jaafreitas/weather-station/station/sensorBMP280.cpp

#include "src/Adafruit_BMP280_Library/Adafruit_BMP280.h"
#include "sensorBMP280.h"
#include "settings.h"

extern "C" {
#include "user_interface.h"
}

Adafruit_BMP280 bmp;

os_timer_t sensorBMP280Timer;
bool canReadSensorBMP280 = false;

void sensorBMP280Read(void *parg) {
  canReadSensorBMP280 = true;
}

void setupSensorBMP280() {
  if (!bmp.begin()) {  
    Serial.println("BMP280 sensor not connected!");
  } else {
    canReadSensorBMP280 = true;
    os_timer_disarm(&sensorBMP280Timer);
    os_timer_setfn(&sensorBMP280Timer, sensorBMP280Read, NULL);
    os_timer_arm(&sensorBMP280Timer, SENSOR_BMP280_READ_INTERVAL, true);
  }
}

void loopSensorBMP280(Conn* conn) {
  if (canReadSensorBMP280) {
    canReadSensorBMP280 = false;

    float hPa = bmp.readPressure() / 100;

    conn->notify_sensor("BMP280/pressure", hPa);
    conn->notify_sensor("BMP280/temperature", bmp.readTemperature());
  }
}
