jaafreitas/weather-station/station/sensorMPXH6300A.cpp

#include "sensorMPXH6300A.h"
#include "settings.h"

extern "C" {
#include "user_interface.h"
}

os_timer_t sensorMPXH6300ATimer;

bool canReadSensorMPXH6300A = true;

void sensorMPXH6300ARead(void *parg) {
  canReadSensorMPXH6300A = true;
}

void setupSensorMPXH6300A() {
  pinMode(SENSOR_MPXH6300A_PIN, INPUT);

  os_timer_disarm(&sensorMPXH6300ATimer);
  os_timer_setfn(&sensorMPXH6300ATimer, sensorMPXH6300ARead, NULL);
  os_timer_arm(&sensorMPXH6300ATimer, SENSOR_MPXH6300A_READ_INTERVAL, true);
}

void loopSensorMPXH6300A(Conn* conn) {
  if (canReadSensorMPXH6300A) {
    canReadSensorMPXH6300A = false;

    int samples = 0;
    float sensorValue;
    while (samples < 1000) {
      sensorValue += analogRead(SENSOR_MPXH6300A_PIN);
      samples++;
    }
    sensorValue /= 1000;

    float volts = (sensorValue / 992.0) * VREF;
    float hPa = 10 * (volts + 0.00353 * VREF_5V) / (0.00318 * VREF_5V);

    if (hPa > 500.0) {
      conn->notify_sensor("MPXH6300A/pressure", hPa);
    }
  }
}
