jaafreitas/weather-station/station/debug.cpp

#include "src/Time/TimeLib.h"
#include "debug.h"
#include "settings.h"
#include "ntp.h"

void setupDebug() {
#ifdef DEBUG
  Serial.begin(74880);
  //Serial.setDebugOutput(true);
#endif
}

void debugMsg(const char* format, ...) {
#ifdef DEBUG
  char str[200];

  va_list args;
  va_start(args, format);

  vsnprintf(str, sizeof(str), format, args);
  Serial.print(str);

  va_end(args);
#endif
}
