jaafreitas/weather-station/(commit log)

2017-04-26 Alarm function. It turns on the internal led in case of values different than 0.
2017-05-05 Temperature and humidity reading from the DHT11 sensor. The Adafruit DHT Sensor Library seems to have some issues while the DHTLib was pretty stable. Now we have a notify method on Conn to allow the 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
    [alarm.cpp, conn.cpp, sensorDHT.cpp, sensorDHT.h, settings.h, station.ino]
2017-05-06 Distance measurement using the Ultrasonic HC-SR04 sensor. Temperature and humidity measurement now happens every 60 seconds and the ultrasonic measurement every 1 second. Let's initiate the canRead v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
2017-05-22 Pressure measurement using the MPXH6300A sensor.
2017-05-22 Time to subscribe to the station's sensors.
2017-05-24 The pressure measurement is a bit unstable, so let's do some sampling. Some voltage reference adjustments for the WeMos. Time will tell if they are good enough.
    [sensorMPXH6300A.cpp, settings.h]
2017-05-27 Expressing the pressure measurement in kPa. Performing more fine tuning in the reference voltages.
2017-09-07 Weather station prototype picture
2017-12-29 Implementation of the BMP280 pressure sensor. Using hPa instead of kPa because the first is more common when we are talking about weather pressure.
2018-09-18 Reconnecting in case we lost communication with MQTT server.
2019-08-30 We didn't need that parameter here.
    [conn.cpp]
2019-08-30 Support for the VL53L0X laser distance sensor.
